ee-herrerar/EL3313-Proyecto-1/docs/ImagenesDocu/DIAGRAMA NIVEL 3 UART_TX.png

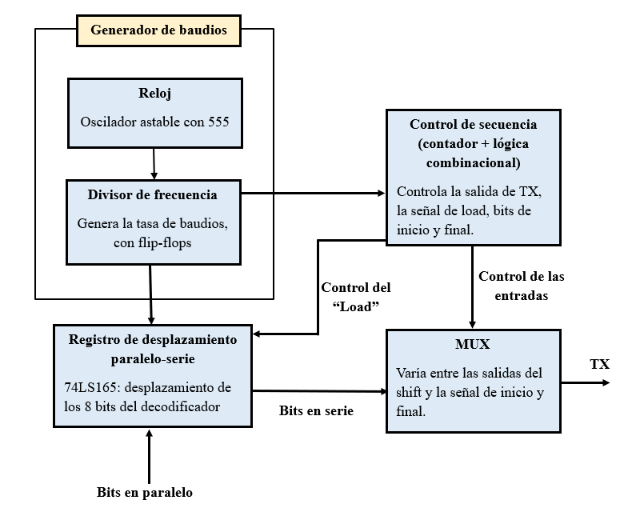
docs/ImagenesDocu/DIAGRAMA NIVEL 3 UART_TX.png
