ee-herrerar/EL3313-Proyecto-1/docs/ImagenesDocu/MUX-ejemplo.png

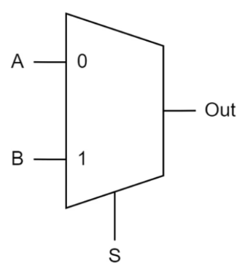
docs/ImagenesDocu/MUX-ejemplo.png
