ee-herrerar/EL3313-Proyecto-1/docs/ImagenesDocu/TablaContador-load-TX.png

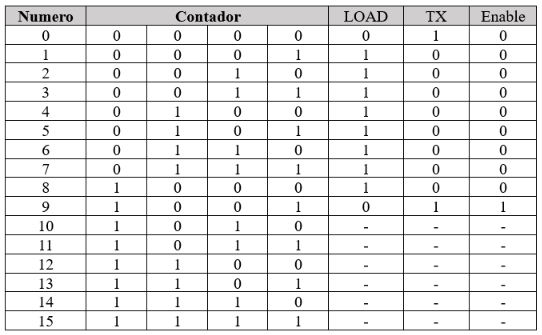
docs/ImagenesDocu/TablaContador-load-TX.png
