ee-herrerar/EL3313-Proyecto-1/docs/ImagenesDocu/TablaContador-MUX.png

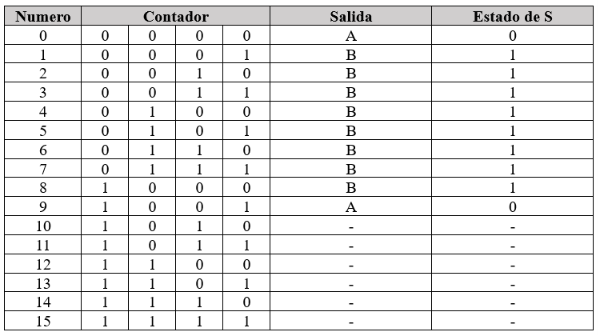
docs/ImagenesDocu/TablaContador-MUX.png
