ee-herrerar/EL3313-Proyecto-1/docs/ImagenesDocu/UART-ModuloDeTransmision 2.png

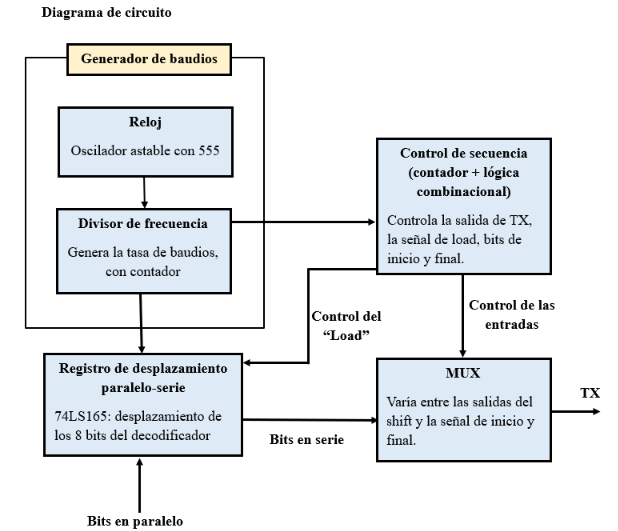
docs/ImagenesDocu/UART-ModuloDeTransmision 2.png
