ee-herrerar/EL3313-Proyecto-1/(commit log)

2026-08-12 Actualización del README (UART)
    Added design approach section detailing UART and MUX modules.
2026-08-12 Enhance README with circuit and UART details
    Added detailed explanations for the discrete circuit and UART transmission module in the README.
2026-08-12 Se agrega imagen y algunas fuentes
    Added references and sources for UART protocol information.
2026-08-12 Update diseño.md with button processing details
    Added explanation of button processing and debounce mechanism.
2026-08-12 Remove UART and MUX sections from README
    Removed detailed explanations of UART and MUX sections from the README.
2026-08-12 Parte UART de transmision
    Added detailed explanation of UART communication protocol and MUX control logic.
2026-08-12 Imágenes de sección UART:transmision
    Updated section headers and added images for UART and MUX.
2026-08-12 Rename UART-Modulo de transmision.png to UART-ModuloDeTransmision.png
2026-08-12 Enhance design documentation for circuit and control
    Added detailed design description for discrete circuit and control subsystem.
2026-08-12 Corrección de nombres de imagen
2026-08-12 Revise diseño.md with project design aspects
    Updated design document to include aspects of the project such as the use of Basys 3, external buttons, FSM, and discrete circuit details.
2026-08-21 Receptor de la UART para FPGA
2026-08-21 Generador de baudios para la FPGA
2026-08-21 Corrección extensión de archivo
2026-08-26 informe tecnico1
    El informe detalla el diseño y desarrollo de un sistema híbrido para el juego Whack-a-mole, que combina lógica discreta y FPGA. Se abordan aspectos como la generación de posiciones, la máquina de estados finitos en la FPGA y la comunicación serial.
2026-08-26 Diagramas de Primer, Segundo y Tercer nivel
2026-08-26 README extendido
    Added detailed sections on state machine, UART communication, button processing, timer implementation, and game over/reset logic.
2026-08-29 Actualización diagrama primer nivel
    Corrected typos and added diagrams for UART module.
2026-08-29 Revise UART transmission diagrams and descriptions
    Updated diagrams and descriptions for UART transmission levels, including changes to the third and fourth level diagrams.
2026-08-29 Cuarto nivel y cálculos de oscilador
    Added detailed explanations and diagrams for UART transmission module design, including calculations for baud rate and duty cycle.
2026-08-29 Fix typos and update image reference in diseño.md
    Corrige errores tipográficos en el documento de diseño, incluyendo el nombre del archivo de imagen y la fórmula del cálculo de frecuencia.
2026-08-29 Fix mathematical expressions in diseño.md
    Corrected mathematical notation for UART frequency and error calculations.
2026-08-29 Revise UART calculations and add diagrams
    Updated equations and descriptions related to UART frequency and error calculations. Added diagrams and clarified the use of BCD counters and logic gates.
2026-08-29 Fix UART frequency formula and update image sizes
    Corrected the formula for UART frequency calculation and updated image dimensions in the documentation.
2026-08-29 Expand UART subsystem documentation
    Added detailed descriptions of UART subsystem design, simulations, and measurements, including error calculations and results.
2026-08-29 Actualizar imágenes y agregar referencia bibliográfica
    Se actualizaron las imágenes en la sección de mediciones experimentales y se agregó una referencia bibliográfica al final del documento.
2026-08-29 Revise UART error calculations and observations
    Updated UART error calculations and observations in informe.md
2026-08-29 Fix formatting of UART TX error percentage
    Updated the formatting of the UART TX error percentage in the report.
2026-08-29 Fix LaTeX formatting for UART error equations
    Updated LaTeX formatting for UART error calculations in informe.md.
2026-08-29 Fix formatting of UART error expression
    Updated the formatting of the UART error expression in the documentation.
2026-08-29 Fix grammar and clarity in diseño.md
    Corrected minor grammatical errors and improved clarity in the UART documentation.
2026-08-29 Actualización de TB explicados
